ARTITULE/LumaTilt/BOM.csv

Item | Qty | Supplier | Cost/item | Total Cost | link
PCB | 1 | JLCPCB | $9.90 | $9.90 | https://jlcpcb.com
Components from LCSC(Please upload the PCB BOM to their website) | 1 | LCSC | $60(Estimated) | $60 | https://www.lcsc.com
Estimated total shipping | 1 |  |  | $20.00
Estimated TOTAL |  |  |  | $89.9
