ARTITULE/LumaTilt/PCB_Files/BOM_PCB_LumaTIlt_v1.0.csv

No. | Quantity | Comment | Designator | Footprint | Value | Manufacturer Part | Manufacturer | Supplier Part | Supplier
1 | 7 | 1uF | C1,C3,C9,C10,C11,C12,C13 | C0402 | 1uF | CL05A105KP5NNNC | SAMSUNG(三星) | C14445 | LCSC
2 | 11 | 100nF | C2,C4,C5,C6,C7,C8,C14,C15,C16,C20,C21 | C0402 | 100nF | CL05B104KB54PNC | SAMSUNG(三星) | C307331 | LCSC
3 | 2 | 10uF | C17,C19 | C0805 | 10uF | CL21A106KAYNNNE | SAMSUNG(三星) | C15850 | LCSC
4 | 1 | 22uF | C18 | C0805 | 22uF | CL21A226MAQNNNE | SAMSUNG(三星) | C45783 | LCSC
5 | 1 | USBLC6-2SC6 | D1 | SOT-23-6_L2.9-W1.6-P0.95-LS2.8-BL |  | USBLC6-2SC6 | ST(意法半导体) | C7519 | LCSC
6 | 2 | HDR-M_2.54_1x3P | H1,H2 | Top side pads
7 | 1728 | 16-213/BHC-AN1P2/3T | LED1,LED2,LED3,LED4,LED5,LED6,LED7,LED8,LED9,LED10,LED11,LED12,LED13,LED14,LED15,LED16,LED17,LED18,LED19,LED20,LED21,LED22,LED23,LED24,LED25,LED26,LED27,LED28,LED29,LED30,LED31,LED32,LED33,LED34,LED35,LED36,LED37,LED38,LED39,LED40,LED41,LED42,LED43,LED44,LED45,LED46,LED47,LED48,LED49,LED50,LED51,LED52,LED53,LED54,LED55,LED56,LED57,LED58,LED59,LED60,LED61,LED62,LED63,LED64,LED65,LED66,LED67,LED68,LED69,LED70,LED71,LED72,LED73,LED74,LED75,LED76,LED77,LED78,LED79,LED80,LED81,LED82,LED83,LED84,LED85,LED86,LED87,LED88,LED89,LED90,LED91,LED92,LED93,LED94,LED95,LED96,LED97,LED98,LED99,LED100,LED101,LED102,LED103,LED104,LED105,LED106,LED107,LED108,LED109,LED110,LED111,LED112,LED113,LED114,LED115,LED116,LED117,LED118,LED119,LED120,LED121,LED122,LED123,LED124,LED125,LED126,LED127,LED128,LED129,LED130,LED131,LED132,LED133,LED134,LED135,LED136,LED137,LED138,LED139,LED140,LED141,LED142,LED143,LED144,LED145,LED146,LED147,LED148,LED149,LED150,LED151,LED152,LED153,LED154,LED155,LED156,LED157,LED158,LED159,LED160,LED161,LED162,LED163,LED164,LED165,LED166,LED167,LED168,LED169,LED170,LED171,LED172,LED173,LED174,LED175,LED176,LED177,LED178,LED179,LED180,LED181,LED182,LED183,LED184,LED185,LED186,LED187,LED188,LED189,LED190,LED191,LED192,LED193,LED194,LED195,LED196,LED197,LED198,LED199,LED200,LED201,LED202,LED203,LED204,LED205,LED206,LED207,LED208,LED209,LED210,LED211,LED212,LED213,LED214,LED215,LED216,LED217,LED218,LED219,LED220,LED221,LED222,LED223,LED224,LED225,LED226,LED227,LED228,LED229,LED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 | LED0402-R-RD |  | 16-213/BHC-AN1P2/3T | EVERLIGHT(亿光) | C131223 | LCSC
8 | 1 | 2N7002ET1G | Q1 | SOT-23-3_L2.9-W1.6-P1.90-LS2.8-BR |  | 2N7002ET1G | onsemi(安森美) | C71533 | LCSC
9 | 24 | PJA3405_R1_00001 | Q2,Q3,Q4,Q5,Q6,Q7,Q8,Q9,Q10,Q11,Q12,Q13,Q14,Q15,Q16,Q17,Q18,Q19,Q20,Q21,Q22,Q23,Q24,Q25 | SOT-23_L2.9-W1.3-P1.90-LS2.4-BR |  | PJA3405_R1_00001 | PANJIT(强茂) | C391632 | LCSC
10 | 34 | 10kΩ | R1,R2,R3,R4,R5,R6,R7,R8,R9,R11,R12,R13,R14,R15,R16,R17,R18,R19,R20,R21,R22,R23,R24,R25,R26,R27,R28,R29,R30,R31,R32,R33,R34,R35 | R0402 | 10kΩ | 0402WGF1002TCE | UNI-ROYAL(厚声) | C25744 | LCSC
11 | 25 | 100Ω | R10,R36,R37,R38,R39,R40,R41,R42,R43,R44,R45,R46,R47,R48,R49,R50,R51,R52,R53,R54,R55,R56,R57,R58,R59 | R0402 | 100Ω | 0402WGF1000TCE | UNI-ROYAL(厚声) | C25076 | LCSC
12 | 2 | 5.1kΩ | R60,R61 | R0402 | 5.1kΩ | 0402WGF5101TCE | UNI-ROYAL(厚声) | C25905 | LCSC
13 | 1 | SKPMDAE011 | SW1 | SW-SMD_L6.0-W6.0-LS6.6 |  | SKPMDAE011 | ALPSALPINE(阿尔卑斯阿尔派) | C370971 | LCSC
14 | 5 | TLC59282DBQR | U1,U2,U3,U4,U5 | SSOP-24_L8.8-W4.0-P0.64-LS6.2-BL |  | TLC59282DBQR | TI(德州仪器) | C129352 | LCSC
15 | 1 | ESP32-C3-MINI-1-N4 | U6 | WIFIM-SMD_ESP32-C3-MINI-1 |  | ESP32-C3-MINI-1-N4 | ESPRESSIF(乐鑫) | C2838502 | LCSC
16 | 3 | 74HCT595BQ,115 | U7,U8,U9 | DHVQFN-16_L3.5-W2.5-P0.50-BL-EP |  | 74HCT595BQ,115 | Nexperia(安世) | C99709 | LCSC
17 | 1 | AMS1117-3.3 | U10 | SOT-223-3_L6.5-W3.4-P2.30-LS7.0-BR |  | AMS1117-3.3 | Advanced Monolithic Systems | C6186 | LCSC
18 | 1 | TYPE-C 16PIN 2MD(073) | USB1 | USB-C-SMD_TYPE-C-16PIN-2MD-073 |  | TYPE-C 16PIN 2MD(073) | SHOU HAN(首韩) | C2765186 | LCSC
