ARTITULE/LumaTilt/PCB_Files/SCH_Schematic1_LumaTilt_v1.0.pdf

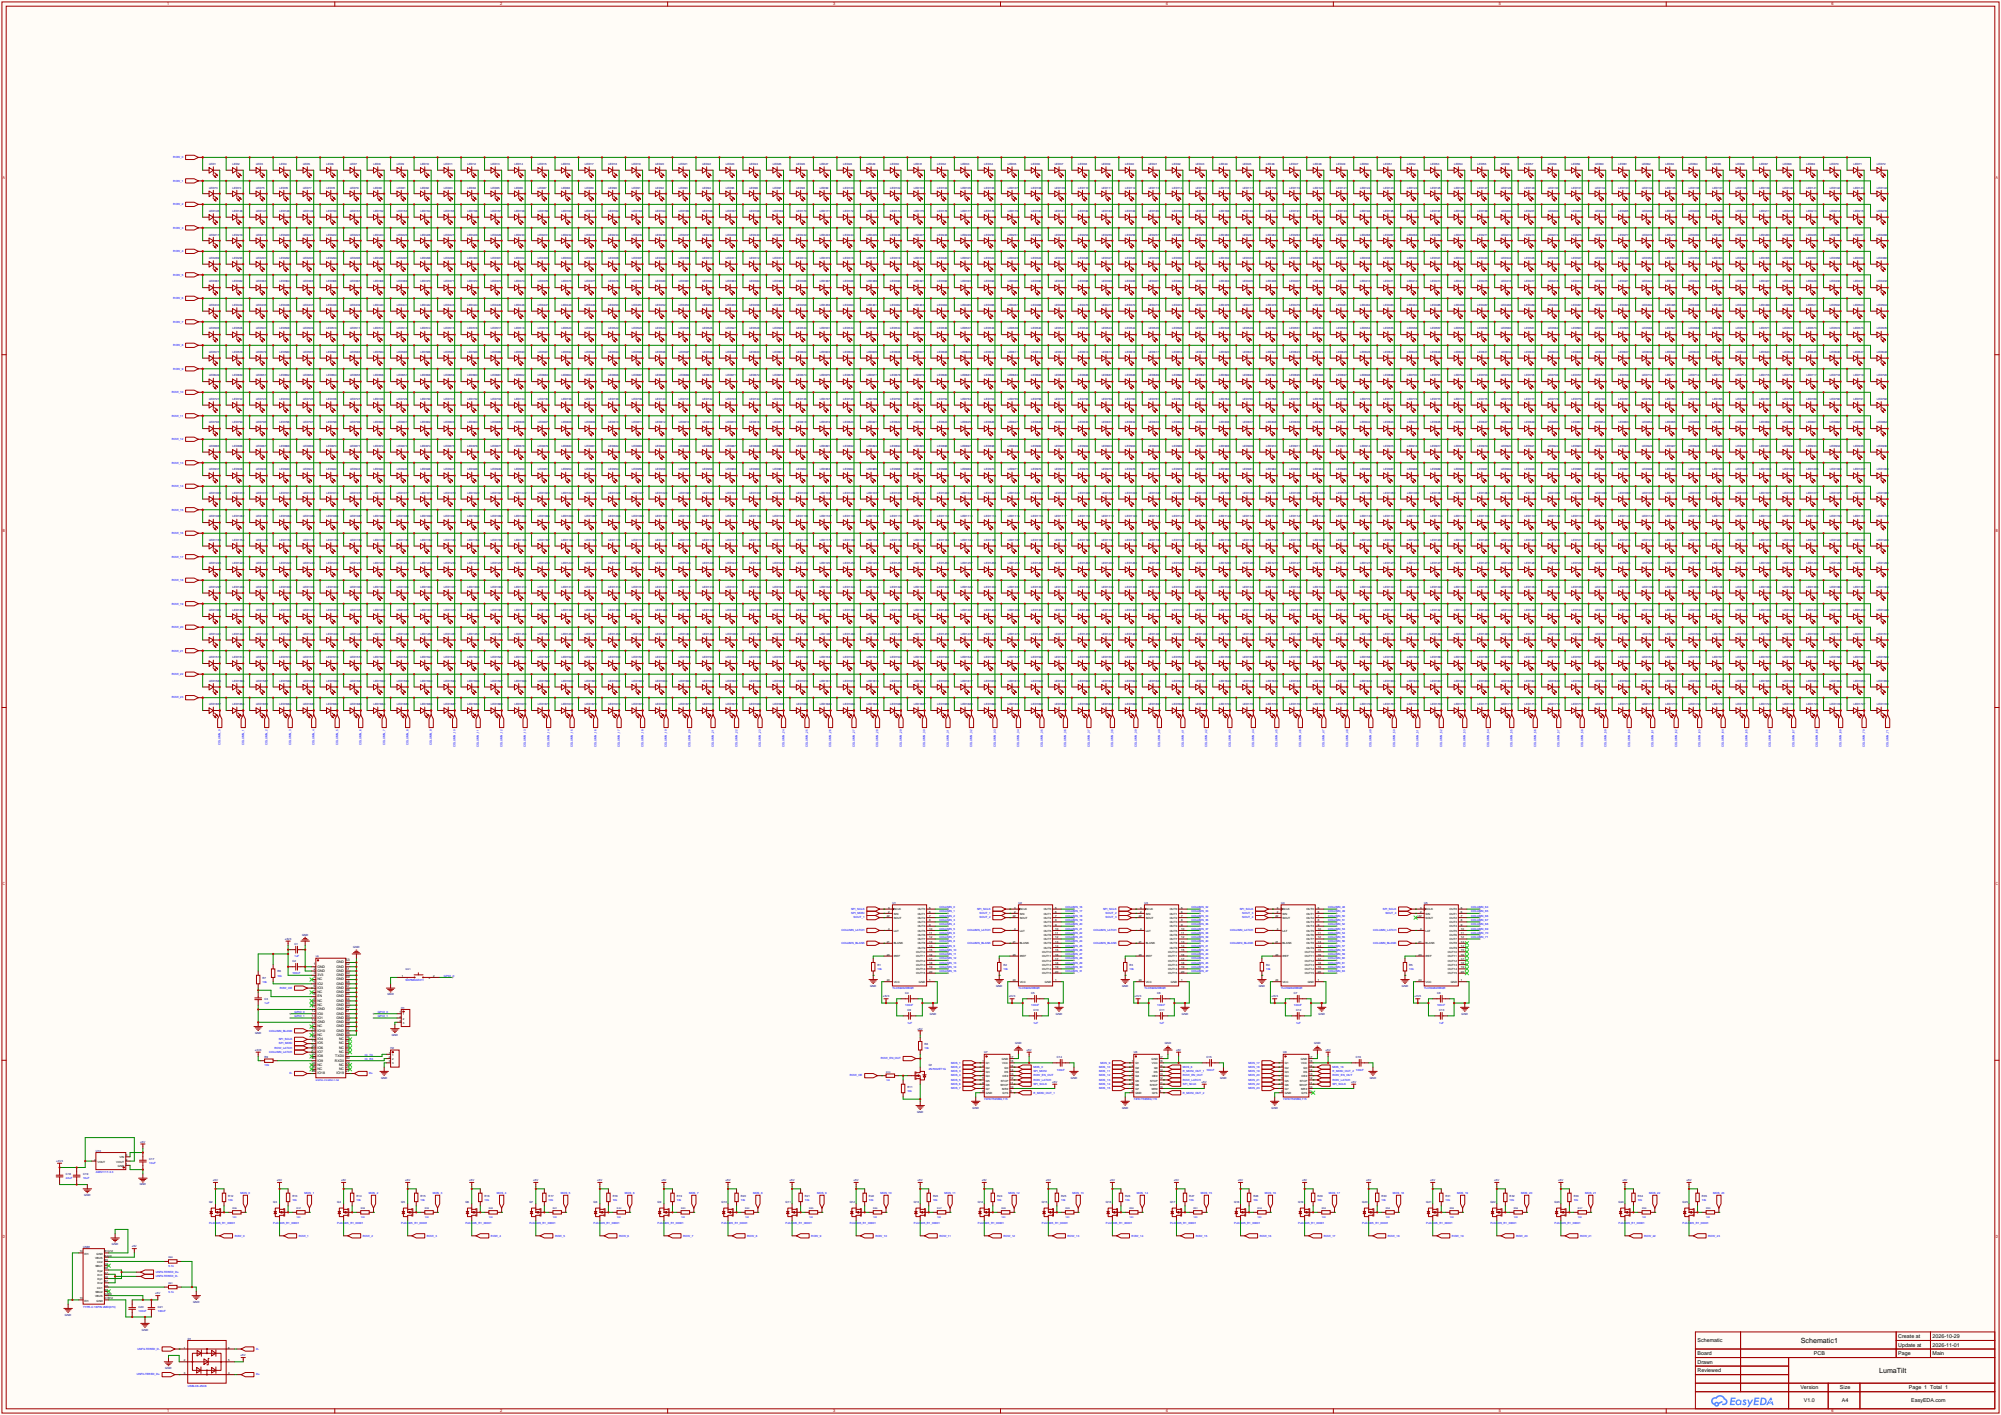
[picture p4: page 1]

Schematic | Schematic1 | Create at | 2026-10-29

Update at | 2026-11-01

Board | PCB | Page | Main
Drawn | | LumaTilt
Reviewed

Version | Size | Page 1 Total 1
V1.0 | A4 | EasyEDA.com
