ARTITULE/LumaTilt/(list of files, drawings)

Other design files:
PCB_Files/Altium_Schematic.schdoc
