ARTITULE/LumaTilt/(commit log)

2026-11-01 Add PCB Files
    [BOM_PCB_LumaTIlt_v1.0.csv, BOM_PCB_LumaTilt_v1.0.xlsx, PickAndPlace_LumaTilt_v1_0.xlsx]
2026-11-01 Add Altium Schematic
    [Altium_Schematic.schdoc]
2026-11-01 Sync LumaTilt from Half Life
    [BOM.csv]
2026-11-01 Update README and BOM
    [BOM.csv]
2026-11-02 Add Button logic
